TuaEsque/mitsubishi-ac-esp32-ir/docs/diagrams/perfboard.png

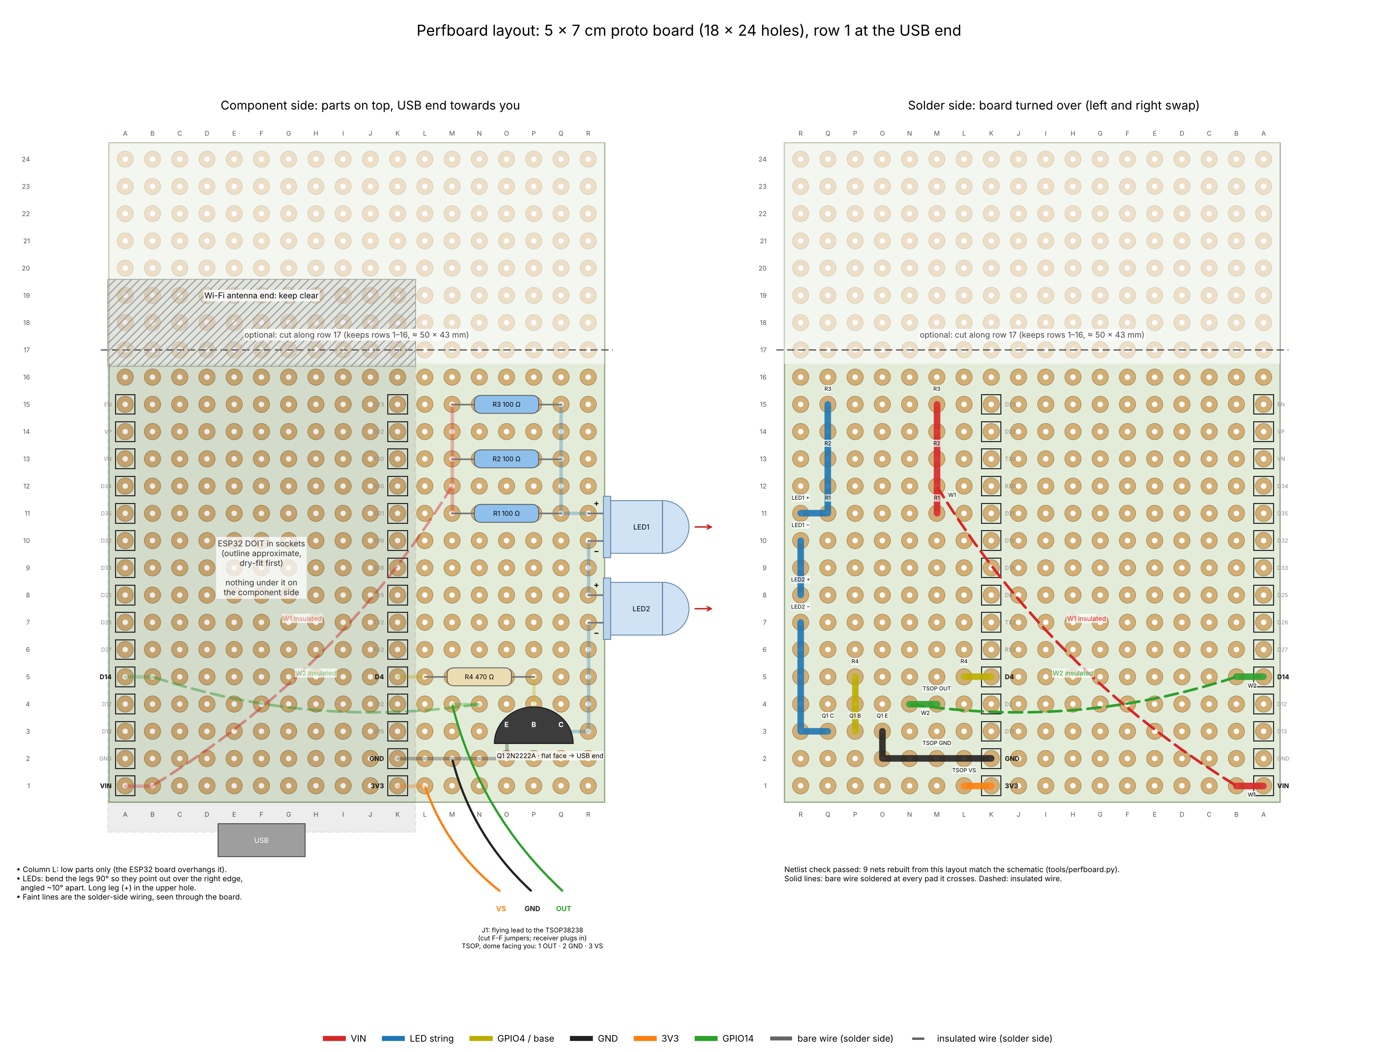
docs/diagrams/perfboard.png
