TuaEsque/mitsubishi-ac-esp32-ir/docs/diagrams/schematic.png

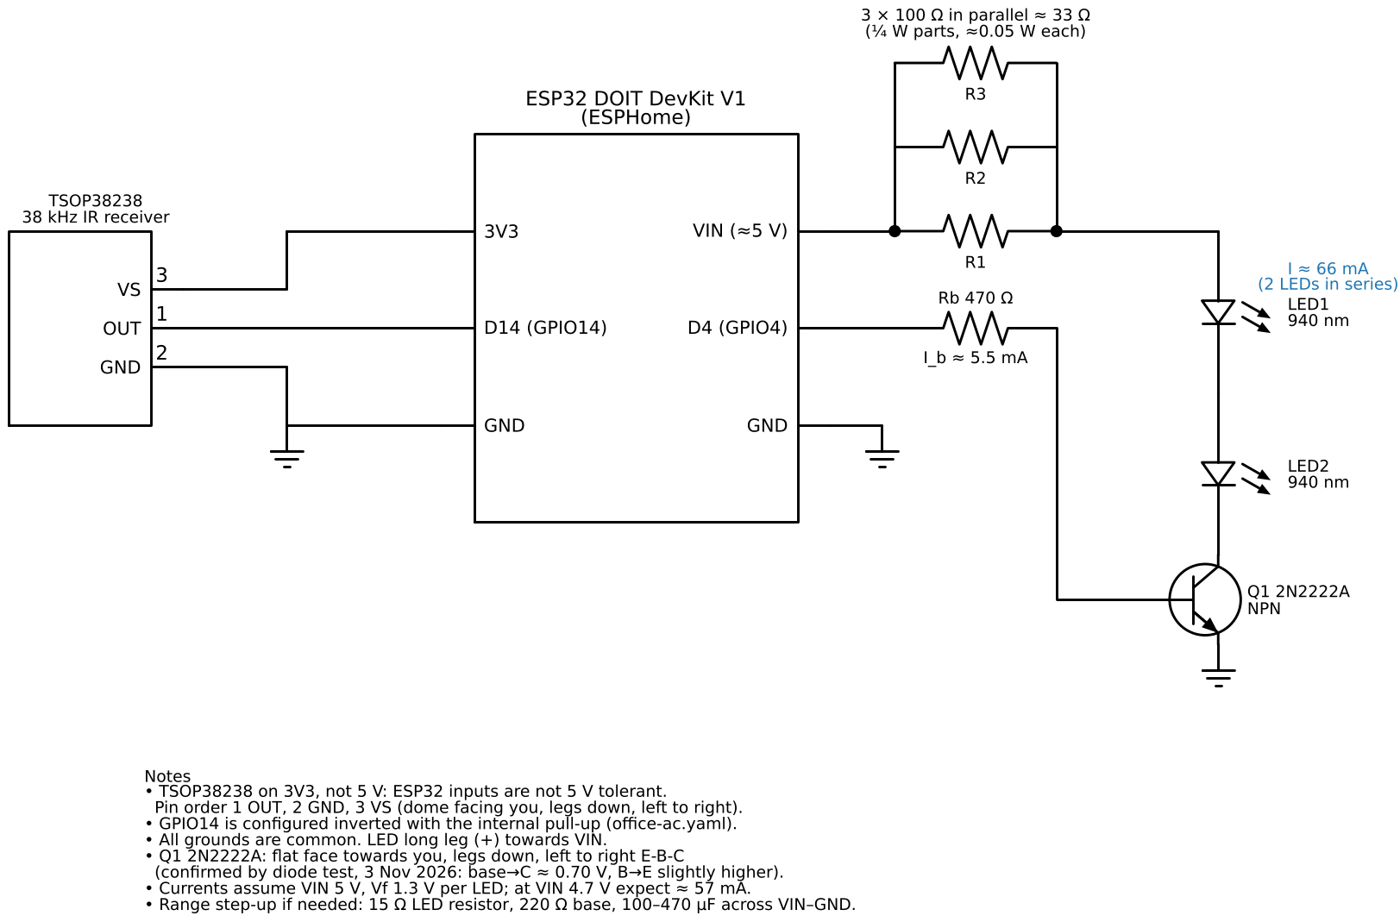
docs/diagrams/schematic.png
