TuaEsque/mitsubishi-ac-esp32-ir/docs/diagrams/system.png

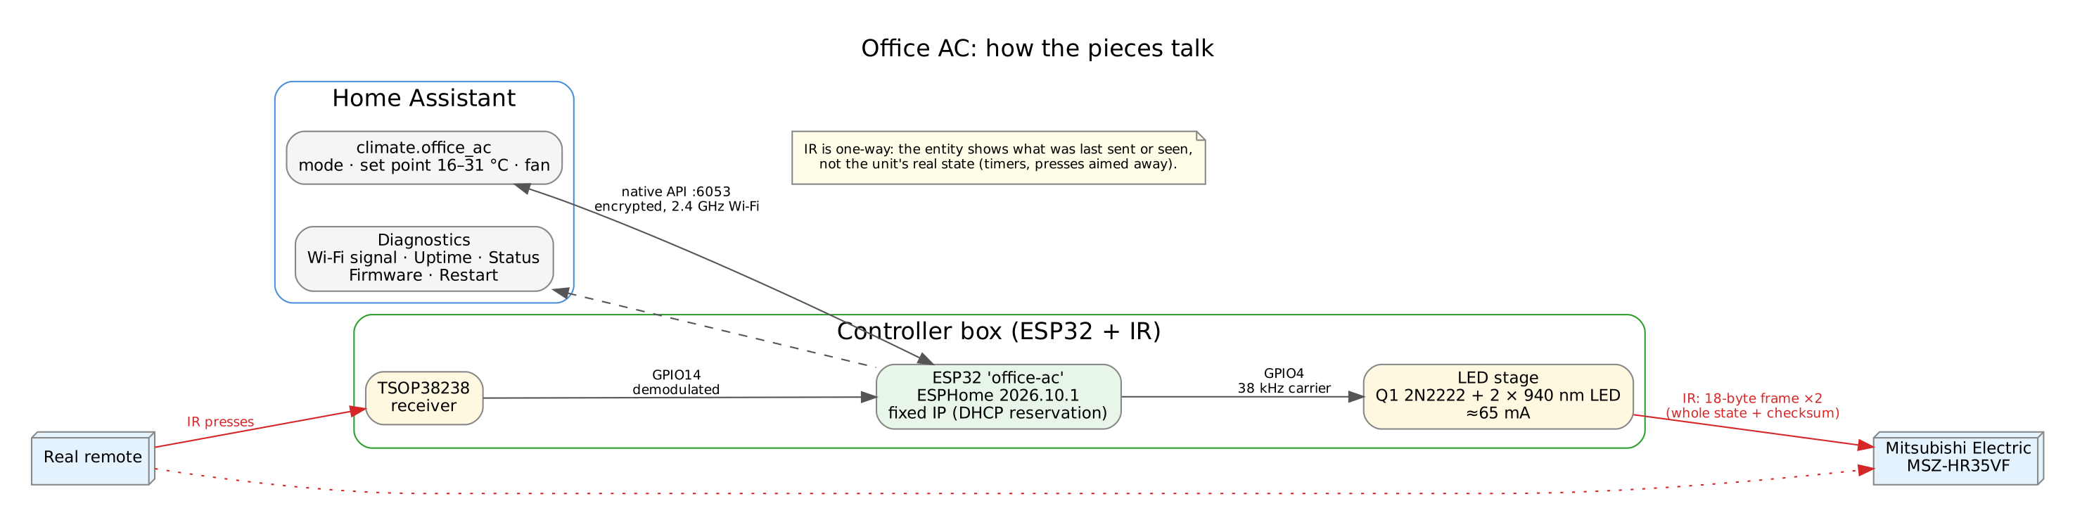
docs/diagrams/system.png
