TuaEsque/mitsubishi-ac-esp32-ir/enclosure/out/enclosure.step

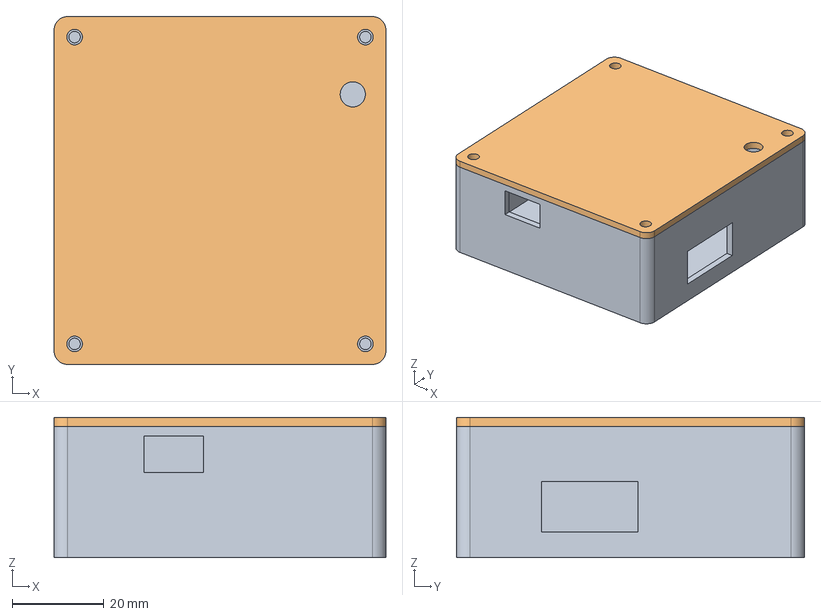
[picture p4: CAD file, 2026-11-12]
enclosure/out/enclosure.step
72.5 x 76.0 x 30.6 mm
