TuaEsque/mitsubishi-ac-esp32-ir/enclosure/out/lid.stl

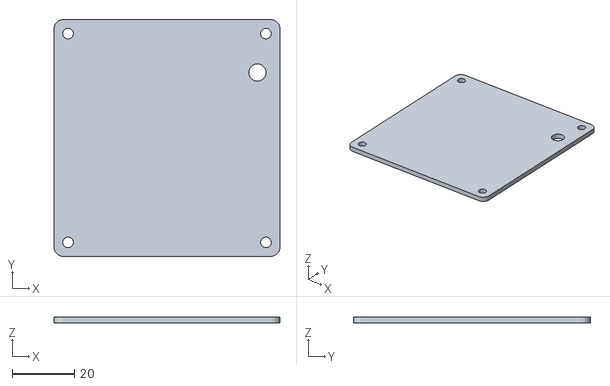
[picture p5: CAD file, 2026-11-12]
enclosure/out/lid.stl
72.5 x 76.0 x 2.00
