TuaEsque/mitsubishi-ac-esp32-ir/enclosure/out/base.stl

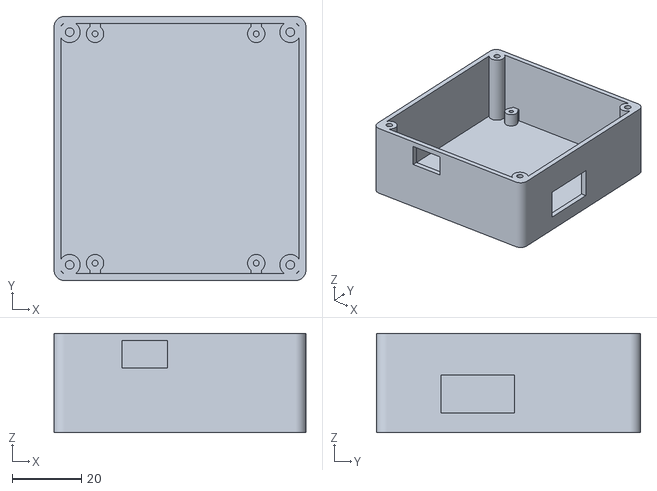
[picture p6: CAD file, 2026-11-12]
enclosure/out/base.stl
72.5 x 76.0 x 28.6
