TuaEsque/mitsubishi-ac-esp32-ir/enclosure/out/fit_test.stl

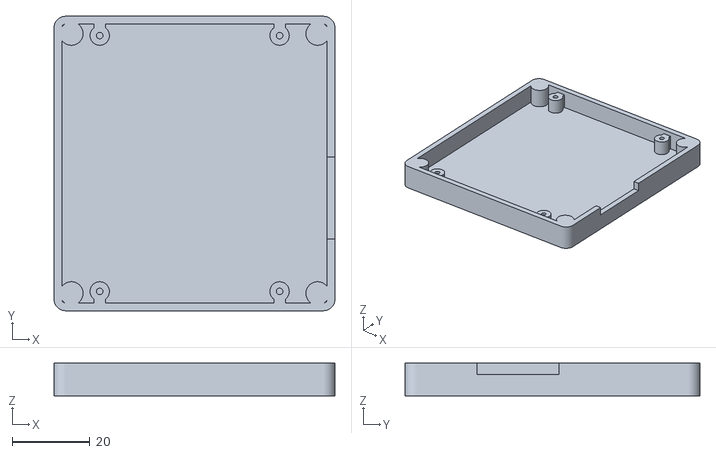
[picture p7: CAD file, 2026-11-12]
enclosure/out/fit_test.stl
72.5 x 76.0 x 8.50
