TuaEsque/mitsubishi-ac-esp32-ir/docs/diagrams/build-status.png

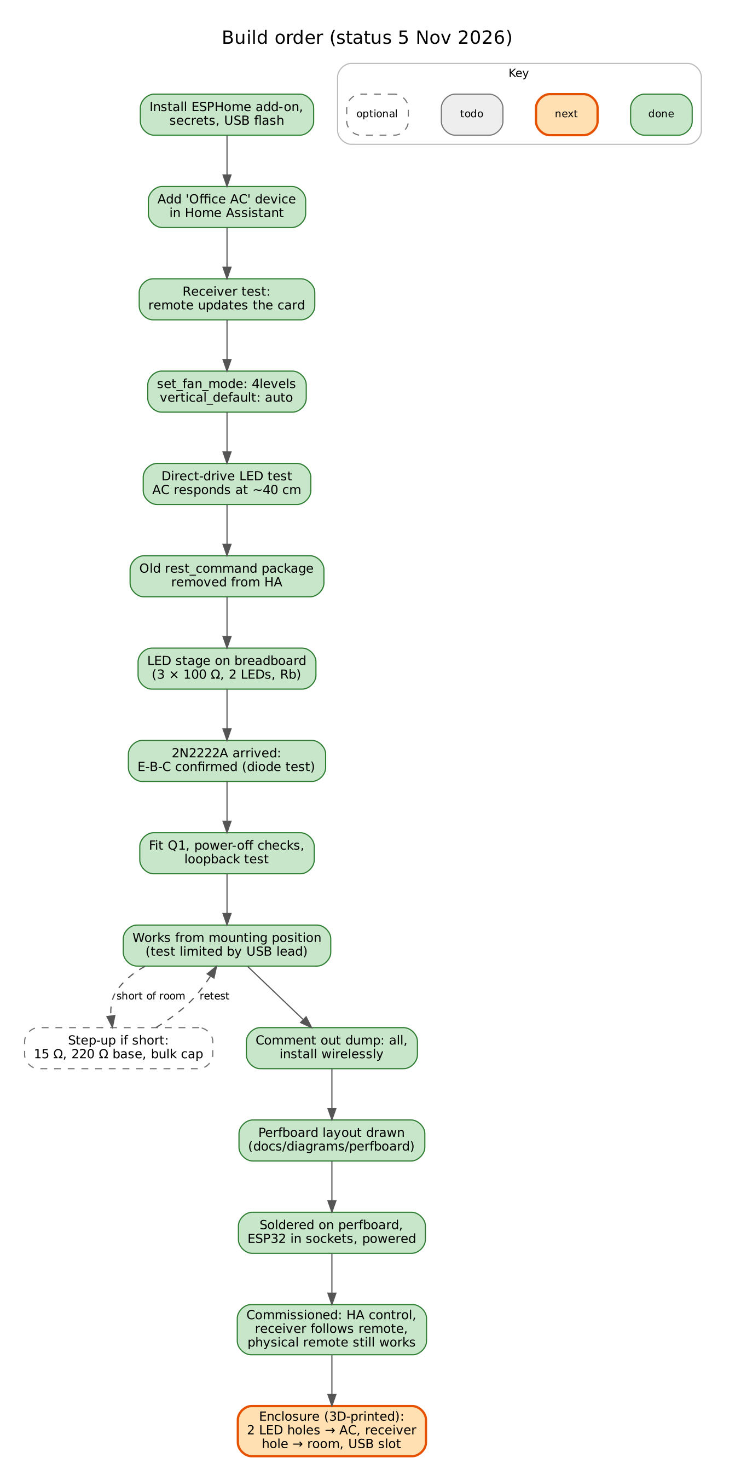
docs/diagrams/build-status.png
