TuaEsque/mitsubishi-ac-esp32-ir/docs/diagrams/wiring.png

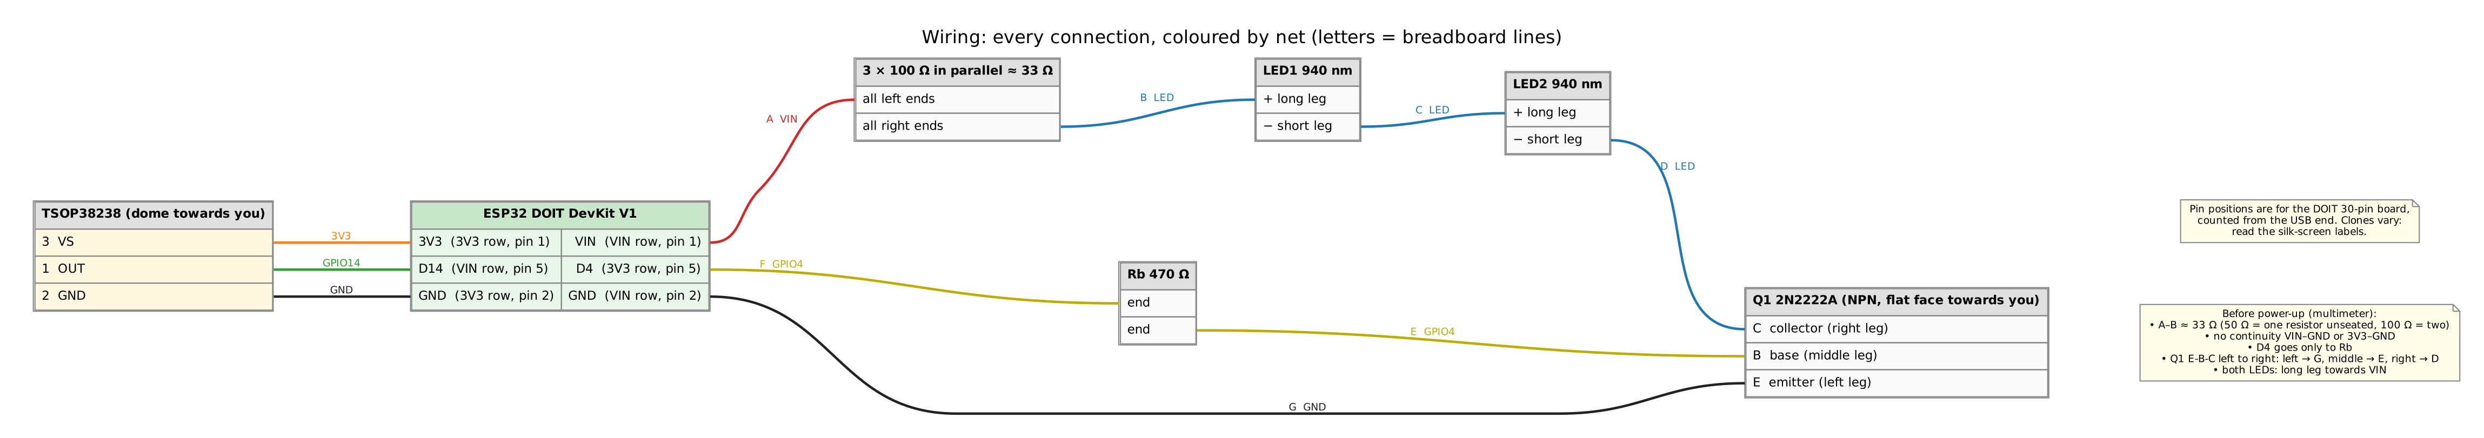
docs/diagrams/wiring.png
