TuaEsque/mitsubishi-ac-esp32-ir/(commit log)

2026-10-29 Add ESP32 IR controller for Mitsubishi MSZ-HR35VF
    - capture and controller firmwares (PlatformIO, IRremoteESP8266)
    - ac_logic.h: all-or-nothing HTTP parameter parsing, PC-testable
    - tools/analyse_ir.py: record/decode/table/diff/encode/emit/selftest
    - Home Assistant rest_command package and ESPHome alternative
    - example logs generated by the library encoders (not a real unit)
    - README with wiring, workflow and honest status
    Not built with PlatformIO or run on an ESP32; not tested on the unit.
    Claude-Session: https://claude.ai/code/session_0113KHwz1biTtwoVKJZeSZHH
2026-10-29 Switch to ESPHome so Office AC appears as a Home Assistant device
    - esphome/office-ac.yaml: validated on ESPHome 2026.10.1; climate entity
    linked to the IR receiver (real remote presses update HA state),
    diagnostics, restart button, OTA encryption reusing the API key
    - esphome/secrets.yaml.example: template for the ESPHome secrets
    - homeassistant/office_ac.yaml: now an optional automation package for
    climate.office_ac (the device itself needs no HA YAML)
    - README.md: ESPHome as the main path; PlatformIO firmware kept as fallback
    - final-build-guide.md: parts, wiring and ESPHome build order
    - .gitignore: ignore ESPHome secrets and build folder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
2026-11-02 Fan 4levels and vane auto confirmed on the MSZ-HR35VF; README test results
2026-11-02 Add final-build diagrams (Schemdraw + Graphviz) and update LED stage wiring
    - tools/diagrams.py generates docs/diagrams/{schematic,wiring,system,build-status}
    as SVG and PNG. Part values live in one Circuit dataclass; currents are computed.
    - final-build-guide.md: LED stage now 3 x 100R in parallel and two LEDs in series
    (as built on 2 Nov), transistor status updated, diagrams embedded.
    - README.md: links the diagrams and shows the system diagram.
    Claude-Session: https://claude.ai/code/session_0113KHwuww5dRgGSbhvLG6cs
2026-11-03 Record confirmed 2N2222A pinout (E-B-C) and update build status
    Diode test on the delivered parts (marked "2N 2222 A331"): base is the
    middle leg, ~0.70 V B->C, B->E slightly higher, OL with black on base.
    Flat face towards you, left to right: E-B-C.
    - diagrams.py: Q1 is 2N2222A with leg positions; checks note maps legs
    to breadboard lines G/E/D; build status moves to "fit Q1".
    - final-build-guide.md: transistor arrived, confirmed pinout section.
    - Regenerated all diagrams.
    Claude-Session: https://claude.ai/code/session_0113KHwvssHdKJXQdkKCzKbn
2026-11-03 LED stage working: power-off checks passed, AC responds from mounting position
    - README status: transmit now via the transistor stage; range not
    measured (limited by USB lead) but works from the mounting position.
    - final-build-guide.md: LED stage status with the check readings.
    - build-status diagram: fit and range done, dump: all is next.
    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
2026-11-03 Add single-board perfboard layout with a netlist check
    tools/perfboard.py holds the layout as data (holes per part leg, bare
    traces and insulated links on the solder side). It rebuilds the nets from
    that data and refuses to draw unless they match the schematic exactly, so
    a moved part can't silently short or open a net. diagrams.py renders it
    as docs/diagrams/perfboard.{svg,png}: component side and mirrored solder
    side.
    Layout: ESP32 in sockets in the bottom-left corner (USB at row 1), all
    parts in the L-R strip, Q1 flat face to the USB end (E-B-C as tested),
    LEDs bent out over the right edge, TSOP38238 on a flying lead. Board can
    be cut at row 17 (~50 x 43 mm).
    final-build-guide.md: place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
    [diagrams.py, perfboard.py]
2026-11-05 Mark perfboard soldered and build commissioned
    Soldered board tested: Home Assistant control works, the receiver follows
    the real remote, and the physical remote still works.
    Only the enclosure is left, planned as a 3D-printed box.
    Claude-Session: https://claude.ai/code/session_0113KHwxznKewvTPLZFHKpxU
2026-11-12 Add parametric 3D-printed enclosure for the perfboard
    build123d model of a base and lid for the uncut 5 x 7 cm board: four
    standoffs under the corner mounting holes (M2 self-tappers), corner lid
    bosses (M3), USB slot at the row-1 end, IR LED window in the column-R
    wall and a receiver hole in the lid. Positions come from the perfboard
    grid and are clash-checked before export. Includes a fit-test print of
    the floor and standoffs, and exported STL/STEP files.
    Claude-Session: https://claude.ai/code/session_0113KHwymJjehCjkKqRKPE9K
    [base.stl, enclosure.step, fit_test.stl, lid.stl]
